kashsuks/kashboard/Renders/top.png

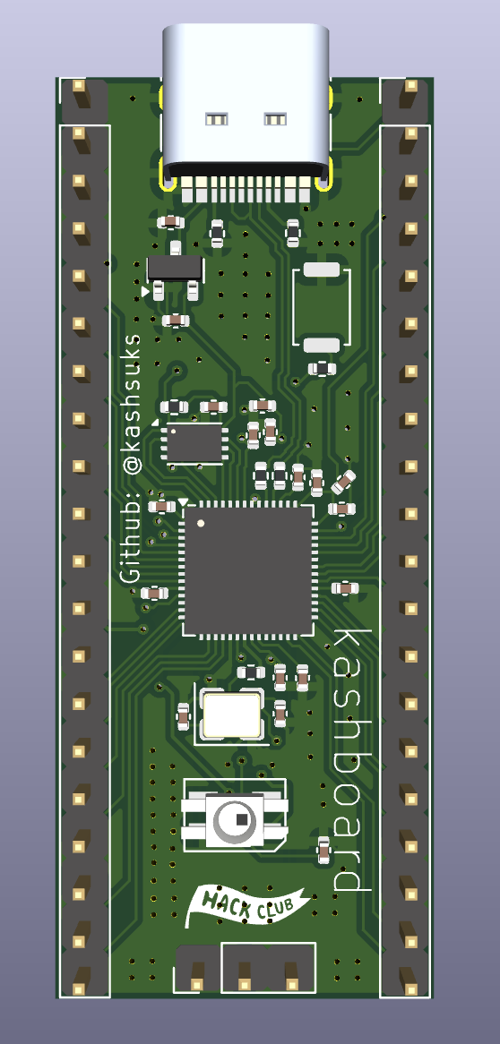
Renders/top.png
