kashsuks/kashboard/README.md

# kashboard

**kasboard** is a devboard that is (sorta) based off me. It is a rp2040 based devboard that follows [this](https://blueprint.hackclub.com/guides/devboard). I added a neopixel _APA102_ that will act as a status light to indicate when the board is turned on and when it is not.
