kashsuks/kashboard/Renders/bot.png

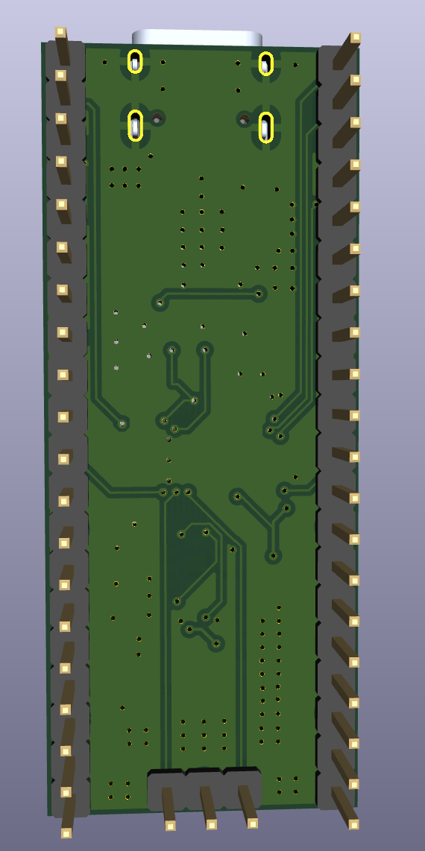
Renders/bot.png
