kashsuks/kashboard/Renders/pcb.png

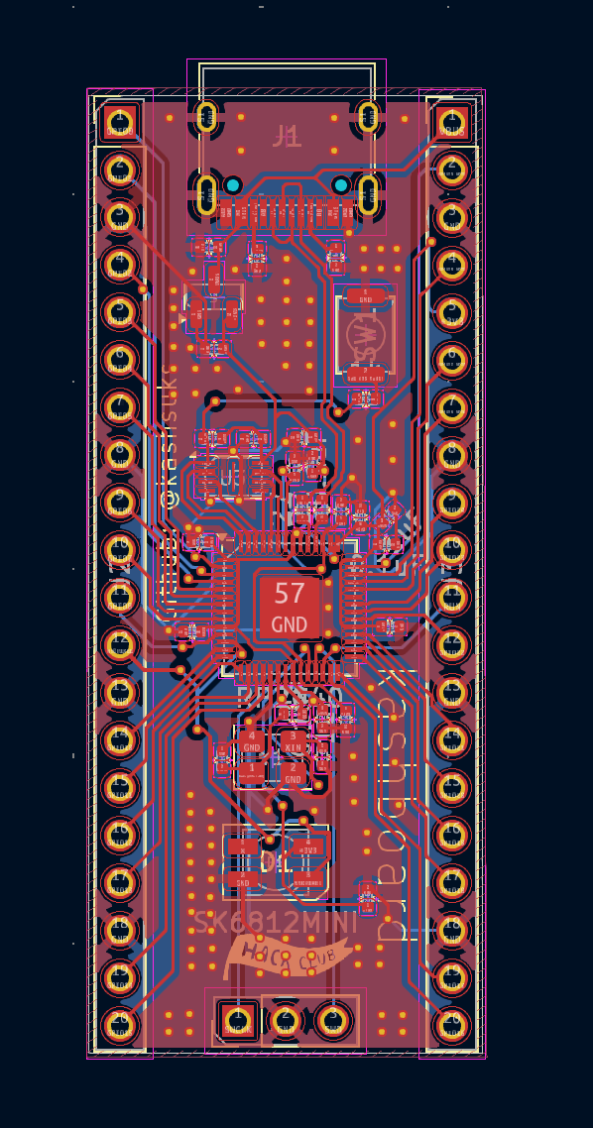
Renders/pcb.png
