kashsuks/kashboard/Renders/schematic.png

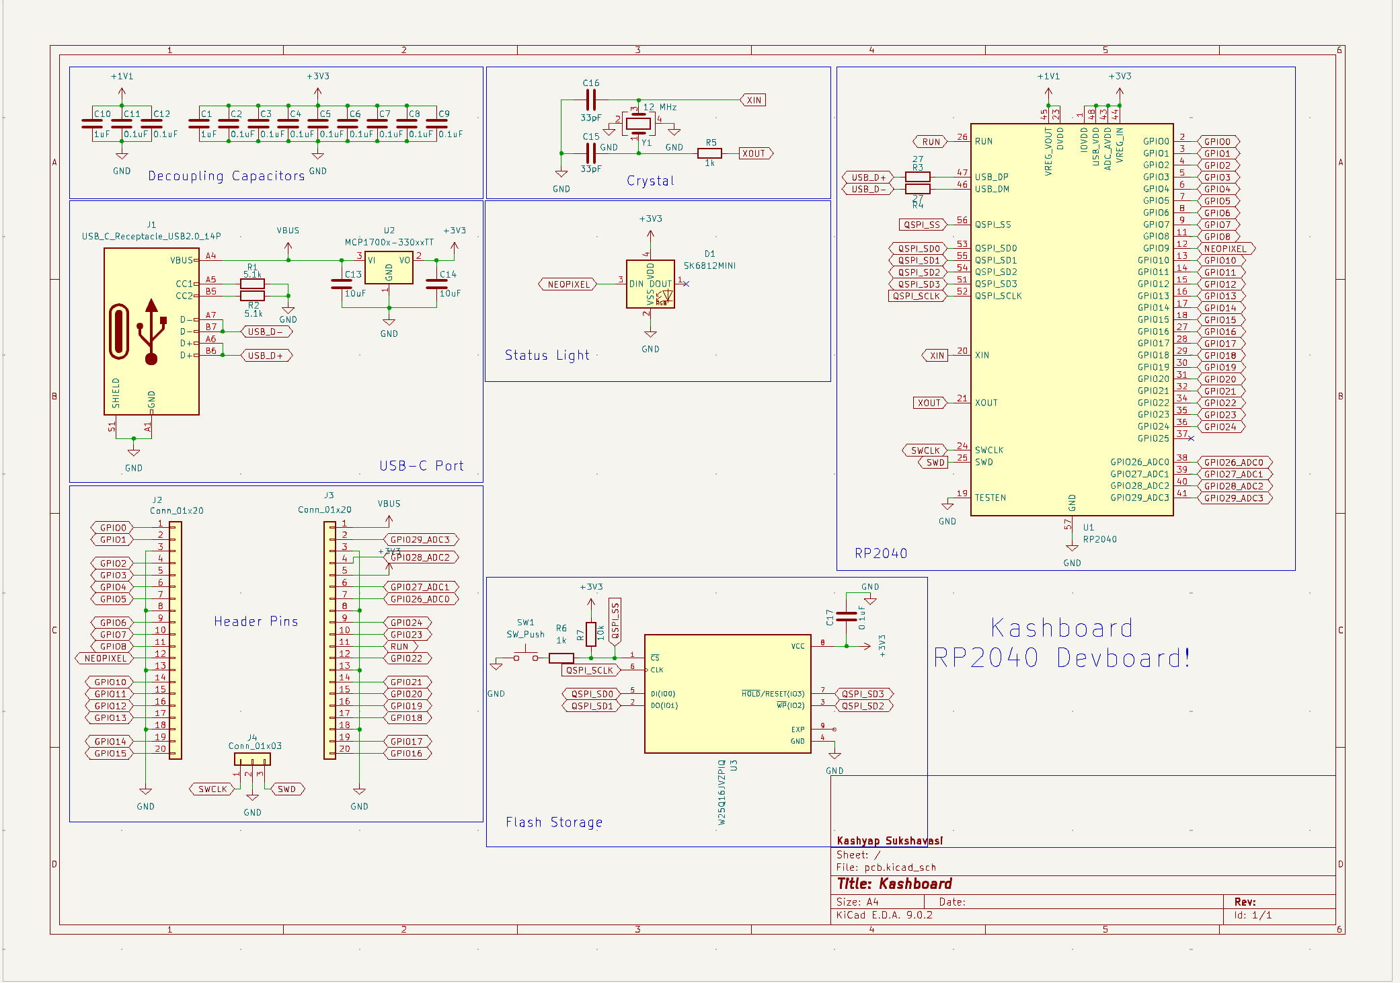
Renders/schematic.png
