kashsuks/kashboard/(commit log)

2025-10-04 got upto the usb-c part
    [pcb.kicad_pcb, pcb.kicad_sch]
2025-10-04 logging off for the night - completed the schematic
    [pcb.kicad_pcb, pcb.kicad_sch]
2025-10-04 feat: added the neopixel status led
    [pcb.kicad_pcb, pcb.kicad_sch]
2025-10-04 finished the schematic and added it to the pcb
    [pcb.kicad_pcb]
2025-10-04 updated the schematic with better formatting
    [pcb.kicad_pcb, pcb.kicad_sch]
2025-10-05 feat: updated most of the pcb, still have some capacitors to wire
    [pcb.kicad_pcb, pcb.kicad_sch]
2025-10-05 holy shit massive update the pcb routing is done
    [pcb.kicad_pcb, pcb.kicad_sch]
2025-10-06 better routing completed
    [pcb.kicad_pcb]
2025-10-06 added some more vias and lined them up
    [pcb.kicad_pcb]
2025-10-06 added silkscreen
    [pcb.kicad_pcb]
2025-10-06 Added production files
    [pcb-B_Cu.gbr, pcb-B_Mask.gbr, pcb-B_Paste.gbr, pcb-B_Silkscreen.gbr, pcb-Edge_Cuts.gbr, pcb-F_Cu.gbr, pcb-F_Mask.gbr, pcb-F_Paste.gbr]
2025-10-08 replaced the apa102 with sk6182 neopixel
    [pcb.kicad_pcb, pcb.kicad_sch]
2025-10-08 added the sk6182 mini 3d model to 3d render
    [pcb.kicad_pcb]
2025-10-08 added schem, pcb, top, and bot renders
2025-10-08 added new production files
    [pcb-B_Cu.gbr, pcb-B_Mask.gbr, pcb-B_Paste.gbr, pcb-B_Silkscreen.gbr, pcb-Edge_Cuts.gbr, pcb-F_Cu.gbr, pcb-F_Mask.gbr, pcb-F_Paste.gbr]
2025-10-13 daily update of pcb files
